eastabrooka/Deltafoc/BaselineRP2040MotorController/BaselineRP2040MotorController.kicad_pcb

## KiCad design BaselineRP2040MotorController/BaselineRP2040MotorController.kicad_pcb (2024-09-08)

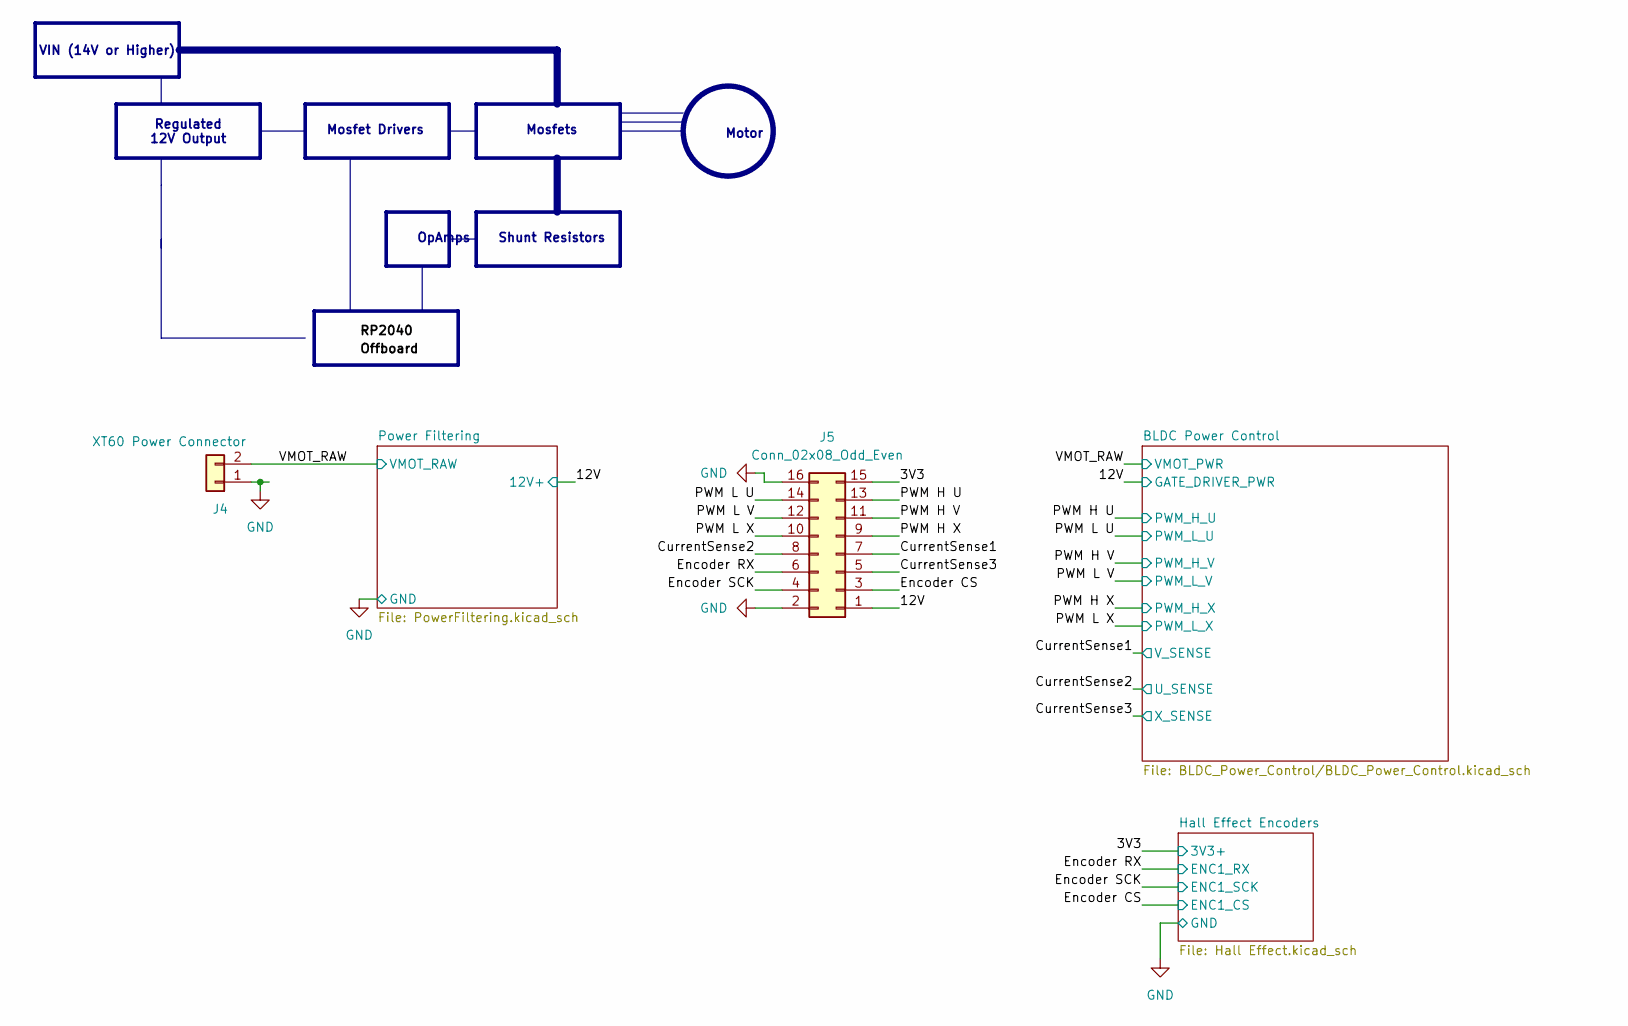
[picture p8: schematic BaselineRP2040MotorController.kicad_sch, BLDC Starting Point]

Parts:
J4: XT60 Power Connector; CONN-TH_XT60UPB-M; LCSC C428722
J5: Conn_02x08_Odd_Even; PinHeader_2x08_P2.54mm_Horizontal

Connections:
+3V3: J5.15; also elsewhere on the board
+12V: J5.1; also elsewhere on the board
/CurrentSense1: J5.7; also elsewhere on the board
/CurrentSense2: J5.8; also elsewhere on the board
/CurrentSense3: J5.5; also elsewhere on the board
/Encoder CS: J5.3; also elsewhere on the board
/Encoder RX: J5.6; also elsewhere on the board
/Encoder SCK: J5.4; also elsewhere on the board
/PWM H U: J5.13; also elsewhere on the board
/PWM H V: J5.11; also elsewhere on the board
/PWM H X: J5.9; also elsewhere on the board
/PWM L U: J5.14; also elsewhere on the board
/PWM L V: J5.12; also elsewhere on the board
/PWM L X: J5.10; also elsewhere on the board
GND: J4.1, J5.2, J5.16; also elsewhere on the board
VMOT_PWR: J4.2; also elsewhere on the board

Notes on the sheet:
Motor
Mosfets
VIN (14V or Higher)
OpAmps
Regulated 12V Output
Shunt Resistors
Mosfet Drivers

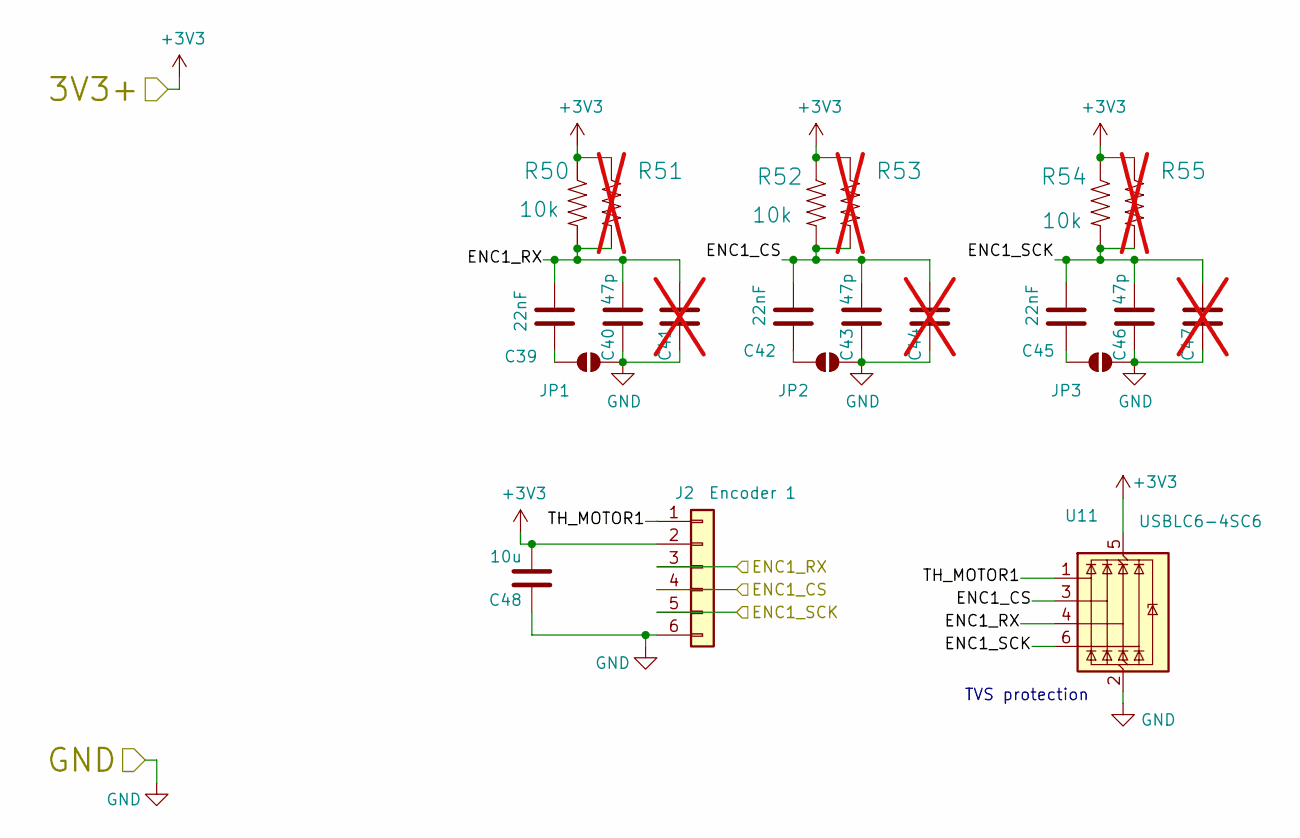
[picture p9: schematic Hall Effect.kicad_sch, BLDC Starting Point]

Parts:
C39, C42, C45: 22nF; C_0805_2012Metric; LCSC C77069
C40, C43, C46: 47p; C_0603_1608Metric; LCSC C1671
C41, C44, C47: C_0805_2012Metric; not fitted
C48: 10u; C_0805_2012Metric; LCSC C15850
J2: Encoder 1; RJ14_Connfly_DS1133-S6_Horizontal; LCSC C2982035
JP1, JP2, JP3: SolderJumper_2_Open; SolderJumper-2_P1.3mm_Open_RoundedPad1.0x1.5mm
R50, R52, R54: 10k; R_0603_1608Metric; LCSC C25804
R51, R53, R55: R_0805_2012Metric; not fitted
U11: USBLC6-4SC6; SOT-23-6; LCSC C558419

Connections:
+3V3: C48.2, J2.2, R50.1, R51.1, R52.1, R53.1, R54.1, R55.1, U11.5 (VBUS); also elsewhere on the board
/Encoder CS: C42.1, C43.2, C44.2, J2.4, R52.2, R53.2, U11.3 (I/O2); also elsewhere on the board
/Encoder RX: C39.2, C40.2, C41.2, J2.3, R50.2, R51.2, U11.4 (I/O3); also elsewhere on the board
/Encoder SCK: C45.1, C46.2, C47.2, J2.5, R54.2, R55.2, U11.6 (I/O4); also elsewhere on the board
/Hall Effect Encoders/TH_MOTOR1: J2.1, U11.1 (I/O1)
GND: C40.1, C41.1, C43.1, C44.1, C46.1, C47.1, C48.1, J2.6, JP1.1 (A), JP2.1 (A), JP3.1 (A), U11.2 (GND); also elsewhere on the board
unnamed: C39.1, JP1.2 (B)
unnamed: C42.2, JP2.2 (B)
unnamed: C45.2, JP3.2 (B)

Notes on the sheet:
TVS protection

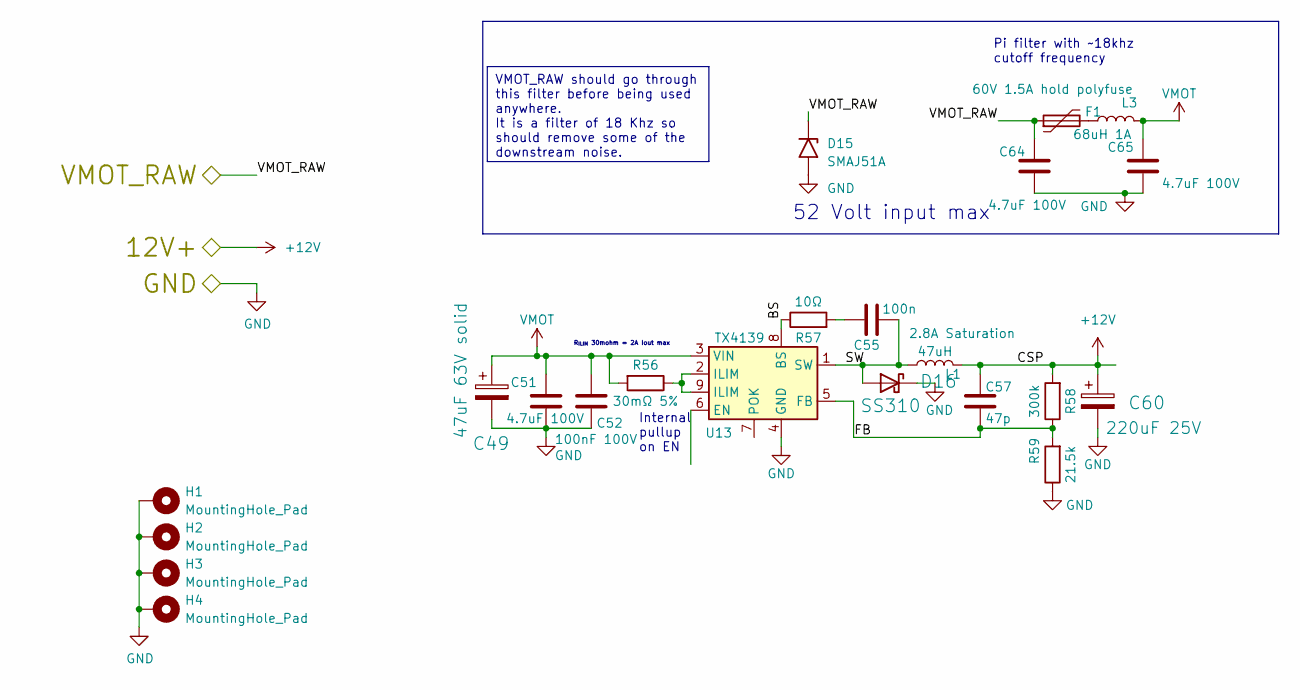
[picture p10: schematic PowerFiltering.kicad_sch, BLDC Starting Point]

Parts:
C49: 47uF 63V solid; CP_Elec_8x10.5; LCSC C5246568
C51, C64, C65: 4.7uF 100V; C_1210_3225Metric; LCSC C342614
C52: 100nF 100V; C_0805_2012Metric; LCSC C28233
C55: 100n; C_0603_1608Metric; LCSC C14663
C57: 47p; C_0603_1608Metric; LCSC C1671
C60: 220uF 25V; CP_Elec_6.3x7.7; LCSC C340768
D15: SMAJ51A; D_SMC; LCSC C438169
D16: SS310; D_SMA; LCSC C15874
F1: 60V 1.5A hold polyfuse; Fuse_2920_7451Metric; LCSC C6165178
H1, H2, H3, H4: MountingHole_Pad; MountingHole_3.2mm_M3_DIN965_Pad_TopBottom
L1: 47uH; L_Chilisin_BMRB00060612; LCSC C5189938
L3: 68uH 1A; L_Sunlord_SWPA6045S; LCSC C53663
R56: 30mΩ 5%; R_0603_1608Metric; LCSC C407492
R57: 10Ω; R_0603_1608Metric; LCSC C22859
R58: 300k; R_0603_1608Metric; LCSC C335091
R59: 21.5k; R_0603_1608Metric; LCSC C705916
U13: TX4139; SOIC-8-1EP_3.9x4.9mm_P1.27mm_EP2.29x3mm_ThermalVias; LCSC C329266

Connections:
+12V: C57.1, C60.1, L1.2, R58.2; also elsewhere on the board
/Power Filtering/BS: R57.1, U13.8 (BS)
/Power Filtering/FB: C57.2, R58.1, R59.2, U13.5 (FB)
/Power Filtering/SW: C55.1, D16.2 (A), L1.1, U13.1 (SW)
GND: C49.2, C51.2, C52.2, C60.2, C64.2, C65.2, D15.2 (A2), D16.1 (K), H1.1, H2.1, H3.1, H4.1, R59.1, U13.4 (GND); also elsewhere on the board
unnamed: C55.2, R57.2
unnamed: F1.2, L3.1
unnamed: R56.1, U13.2 (ILIM), U13.9 (ILIM)
VMOT: C49.1, C51.1, C52.1, C65.1, L3.2, R56.2, U13.3 (VIN)
VMOT_PWR: C64.1, D15.1 (A1), F1.1; also elsewhere on the board

Notes on the sheet:
VMOT_RAW should go through this filter before being used anywhere. It is a filter of 18 Khz so should remove some of the downstream noise.
Internal pullup on EN
52 Volt input max
R_{ILIM} 30mohm = 2A Iout max
Pi filter with ~18khz cutoff frequency

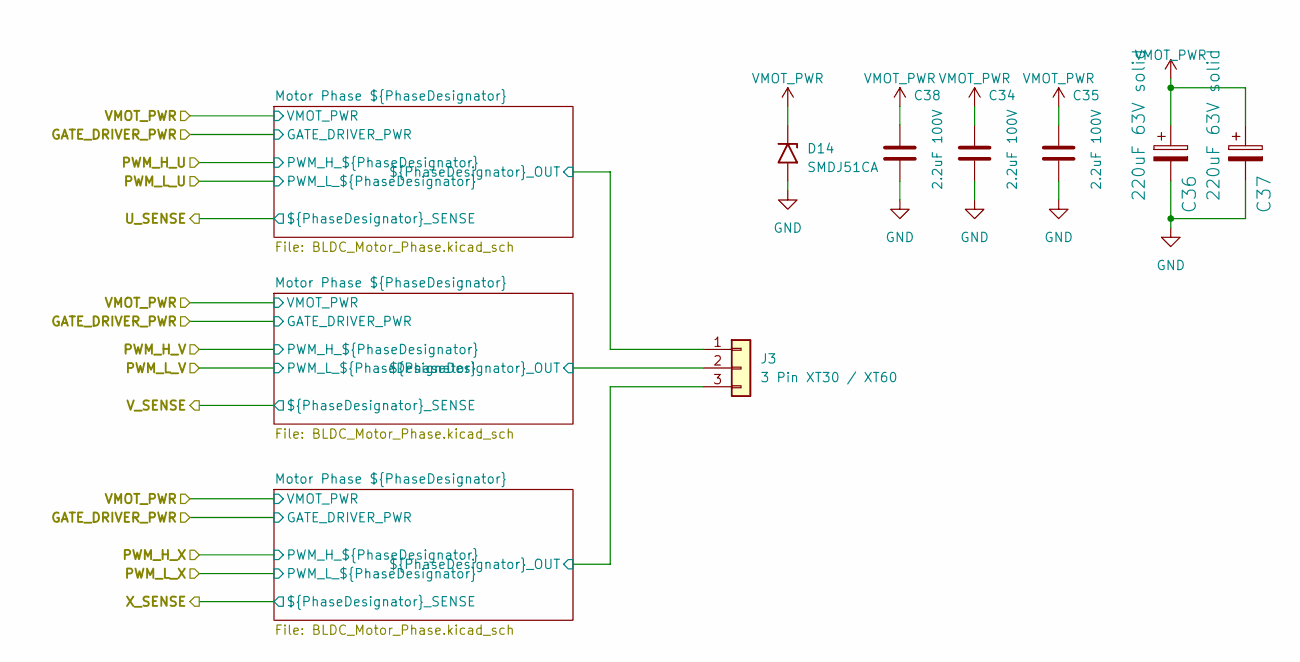
[picture p11: schematic BLDC_Power_Control.kicad_sch, BLDC Starting Point]

Parts:
C34, C35, C38: 2.2uF 100V; C_1206_3216Metric; LCSC C650969
C36, C37: 220uF 63V solid; CP_Elec_8x10; MPN 2210631013R00; LCSC C5455531
D14: SMDJ51CA; D_SMF; LCSC C406702
J3: 3 Pin XT30 / XT60; MT60-F.G.Y; LCSC C99176

Connections:
/BLDC Power Control/Motor Phase U/A_N: J3.1; also elsewhere on the board
/BLDC Power Control/Motor Phase V/A_N: J3.2; also elsewhere on the board
/BLDC Power Control/Motor Phase X/A_N: J3.3; also elsewhere on the board
GND: C34.2, C35.2, C36.2, C37.2, C38.2, D14.2 (A2); also elsewhere on the board
VMOT_PWR: C34.1, C35.1, C36.1, C37.1, C38.1, D14.1 (A1); also elsewhere on the board

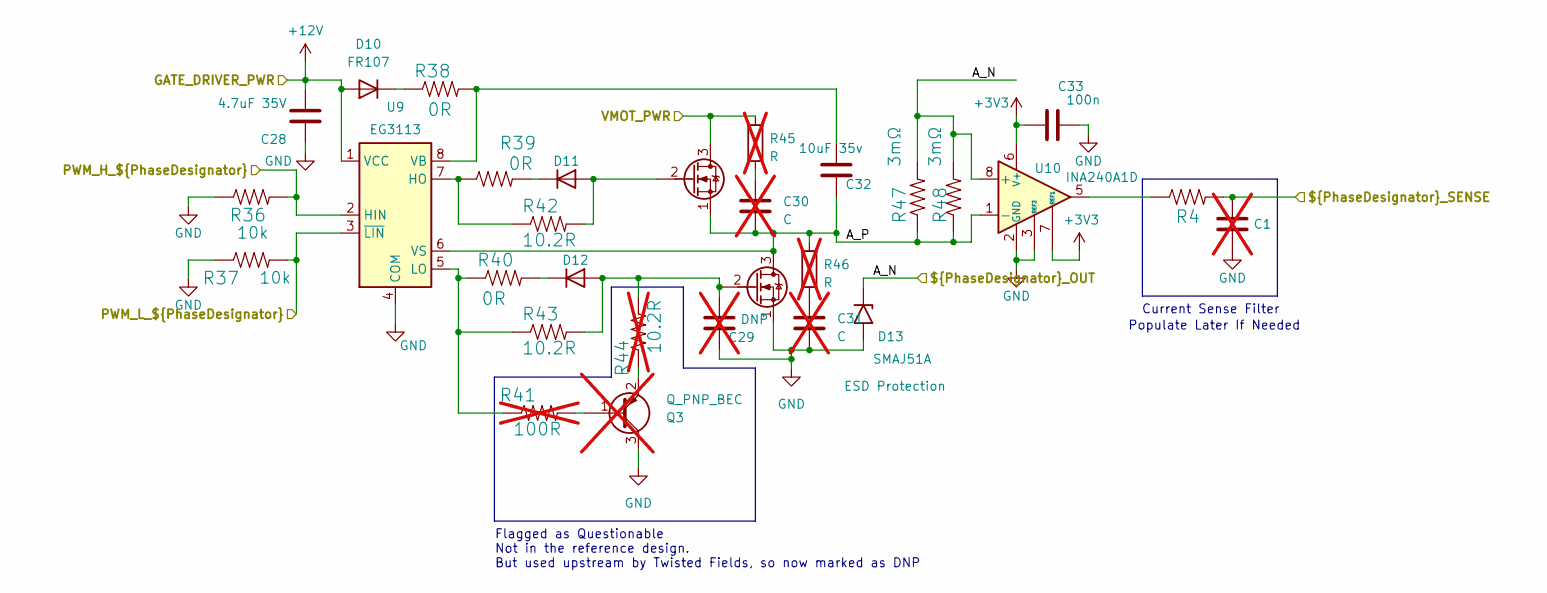
[picture p12: schematic BLDC_Motor_Phase.kicad_sch, BLDC Starting Point]

Parts:
AH3: MOSFETSO-8; PowerPAK_SO-8_123; LCSC C501507
AL3: MOSFETSO-8; PowerPAK_SO-8_123; LCSC C501507
C1: 0; C_0603_1608Metric; LCSC C14663; not fitted
C28: 4.7uF 35V; C_0603_1608Metric; LCSC C162274
C29: DNP; C_0603_1608Metric; not fitted
C30, C31: C; C_0805_2012Metric; not fitted
C32: 10uF 35v; C_0603_1608Metric; LCSC C194427
C33: 100n; C_0603_1608Metric; LCSC C14663
D10: FR107; D_SOD-123; LCSC C511885
D11, D12: CDBU0130R-HF; D_SOD-523; LCSC C2886025
D13: SMAJ51A; D_SMF; LCSC C726760
Q3: Q_PNP_BEC; SOT-23; LCSC C686646; not fitted
R4: 0; R_0603_1608Metric; LCSC C2933129
R36, R37: 10k; R_0603_1608Metric; LCSC C25804
R38, R39, R40: 0R; R_0603_1608Metric; LCSC C21189
R41: 100R; R_0603_1608Metric; LCSC C22775; not fitted
R42, R43: 10.2R; R_0603_1608Metric; LCSC C2933129
R44: 10.2R; R_0603_1608Metric; LCSC C2933129; not fitted
R45, R46: R; R_0805_2012Metric; not fitted
R47, R48: 3mΩ; R_2512_6332Metric; LCSC C2688862
U9: EG3113; SOIC-8_3.9x4.9mm_P1.27mm; LCSC C480666
U10: INA240A1D; SOIC-8_3.9x4.9mm_P1.27mm; LCSC C1346458

Connections:
+3V3: C33.1, U10.6 (V+), U10.7 (REF1); also elsewhere on the board
+12V: C28.2, D10.2 (A), U9.1 (VCC); also elsewhere on the board
/BLDC Power Control/Motor Phase X/A_N: D13.1 (A1), R47.2, R48.2, U10.8 (+); also elsewhere on the board
/BLDC Power Control/Motor Phase X/A_P: AH3.1 (S), AL3.3 (D), C30.2, C32.1, R46.1, R47.1, R48.1, U9.6 (VS), U10.1 (-)
/CurrentSense2: C1.2, R4.2; also elsewhere on the board
/PWM H X: R36.2, U9.2 (HIN); also elsewhere on the board
/PWM L X: R37.2, U9.3 (~LIN); also elsewhere on the board
GND: AL3.1 (S), C1.1, C28.1, C29.1, C31.2, C33.2, D13.2 (A2), Q3.3 (C), R36.1, R37.1, U9.4 (COM), U10.2 (GND), U10.3 (REF2), U10.4 (GND); also elsewhere on the board
unnamed: AH3.2 (G), D11.2 (A), R42.2
unnamed: AL3.2 (G), C29.2, D12.2 (A), R43.2, R44.2
unnamed: C30.1, R45.2
unnamed: C31.1, R46.2
unnamed: D10.1 (K), R38.1
unnamed: D11.1 (K), R39.2
unnamed: D12.1 (K), R40.2
unnamed: Q3.1 (B), R41.2
unnamed: Q3.2 (E), R44.1
unnamed: R39.1, R42.1, U9.7 (HO)
unnamed: R40.1, R41.1, R43.1, U9.5 (LO)
unnamed: C32.2, R38.2, U9.8 (VB)
VMOT_PWR: AH3.3 (D), R45.1; also elsewhere on the board

Parts of its further copies:
AH1, AH2: MOSFETSO-8; PowerPAK_SO-8_123; LCSC C501507
AL1, AL2: MOSFETSO-8; PowerPAK_SO-8_123; LCSC C501507
C2, C3: 0; C_0603_1608Metric; LCSC C14663; not fitted
C16, C22: 4.7uF 35V; C_0603_1608Metric; LCSC C162274
C17, C23: DNP; C_0603_1608Metric; not fitted
C18, C19, C24, C25: C; C_0805_2012Metric; not fitted
C20, C26: 10uF 35v; C_0603_1608Metric; LCSC C194427
C21, C27: 100n; C_0603_1608Metric; LCSC C14663
D2, D6: FR107; D_SOD-123; LCSC C511885
D3, D4, D7, D8: CDBU0130R-HF; D_SOD-523; LCSC C2886025
D5, D9: SMAJ51A; D_SMF; LCSC C726760
Q1, Q2: Q_PNP_BEC; SOT-23; LCSC C686646; not fitted
R5, R6: 0; R_0603_1608Metric; LCSC C2933129
R10, R11, R23, R24: 10k; R_0603_1608Metric; LCSC C25804
R12, R13, R14, R25, R26, R27: 0R; R_0603_1608Metric; LCSC C21189
R15, R28: 100R; R_0603_1608Metric; LCSC C22775; not fitted
R16, R17, R29, R30: 10.2R; R_0603_1608Metric; LCSC C2933129
R18, R31: 10.2R; R_0603_1608Metric; LCSC C2933129; not fitted
R19, R20, R32, R33: R; R_0805_2012Metric; not fitted
R21, R22, R34, R35: 3mΩ; R_2512_6332Metric; LCSC C2688862
U5, U7: EG3113; SOIC-8_3.9x4.9mm_P1.27mm; LCSC C480666
U6, U8: INA240A1D; SOIC-8_3.9x4.9mm_P1.27mm; LCSC C1346458

Connections of its further copies:
+3V3: C21.1, C27.1, U6.6 (V+), U6.7 (REF1), U8.6 (V+), U8.7 (REF1); also elsewhere on the board
+12V: C16.2, C22.2, D2.2 (A), D6.2 (A), U5.1 (VCC), U7.1 (VCC); also elsewhere on the board
/BLDC Power Control/Motor Phase U/A_N: D5.1 (A1), R21.2, R22.2, U6.8 (+); also elsewhere on the board
/BLDC Power Control/Motor Phase U/A_P: AH1.1 (S), AL1.3 (D), C18.2, C20.1, R20.1, R21.1, R22.1, U5.6 (VS), U6.1 (-)
/BLDC Power Control/Motor Phase V/A_N: D9.1 (A1), R34.2, R35.2, U8.8 (+); also elsewhere on the board
/BLDC Power Control/Motor Phase V/A_P: AH2.1 (S), AL2.3 (D), C24.2, C26.1, R33.1, R34.1, R35.1, U7.6 (VS), U8.1 (-)
/CurrentSense1: C2.2, R5.2; also elsewhere on the board
/CurrentSense3: C3.2, R6.2; also elsewhere on the board
/PWM H U: R10.2, U5.2 (HIN); also elsewhere on the board
/PWM H V: R23.2, U7.2 (HIN); also elsewhere on the board
/PWM L U: R11.2, U5.3 (~LIN); also elsewhere on the board
/PWM L V: R24.2, U7.3 (~LIN); also elsewhere on the board
GND: AL1.1 (S), AL2.1 (S), C2.1, C3.1, C16.1, C17.1, C19.2, C21.2, C22.1, C23.1, C25.2, C27.2, D5.2 (A2), D9.2 (A2), Q1.3 (C), Q2.3 (C), R10.1, R11.1, R23.1, R24.1, U5.4 (COM), U6.2 (GND), U6.3 (REF2), U6.4 (GND), U7.4 (COM), U8.2 (GND), U8.3 (REF2), U8.4 (GND); also elsewhere on the board
unnamed: AH1.2 (G), D3.2 (A), R16.2
unnamed: AH2.2 (G), D7.2 (A), R29.2
unnamed: AL1.2 (G), C17.2, D4.2 (A), R17.2, R18.2
unnamed: AL2.2 (G), C23.2, D8.2 (A), R30.2, R31.2
unnamed: C18.1, R19.2
unnamed: C19.1, R20.2
unnamed: C24.1, R32.2
unnamed: C25.1, R33.2
unnamed: D2.1 (K), R12.1
unnamed: D3.1 (K), R13.2
unnamed: D4.1 (K), R14.2
unnamed: D6.1 (K), R25.1
unnamed: D7.1 (K), R26.2
unnamed: D8.1 (K), R27.2
unnamed: Q1.1 (B), R15.2
unnamed: Q1.2 (E), R18.1
unnamed: Q2.1 (B), R28.2
unnamed: Q2.2 (E), R31.1
unnamed: R5.1, U8.5
unnamed: R13.1, R16.1, U5.7 (HO)
unnamed: R14.1, R15.1, R17.1, U5.5 (LO)
unnamed: C20.2, R12.2, U5.8 (VB)
unnamed: R26.1, R29.1, U7.7 (HO)
unnamed: R27.1, R28.1, R30.1, U7.5 (LO)
unnamed: C26.2, R25.2, U7.8 (VB)
VMOT_PWR: AH1.3 (D), AH2.3 (D), R19.1, R32.1; also elsewhere on the board

Notes on the sheet:
Populate Later If Needed
Flagged as Questionable Not in the reference design. But used upstream by Twisted Fields, so now marked as DNP
Current Sense Filter

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
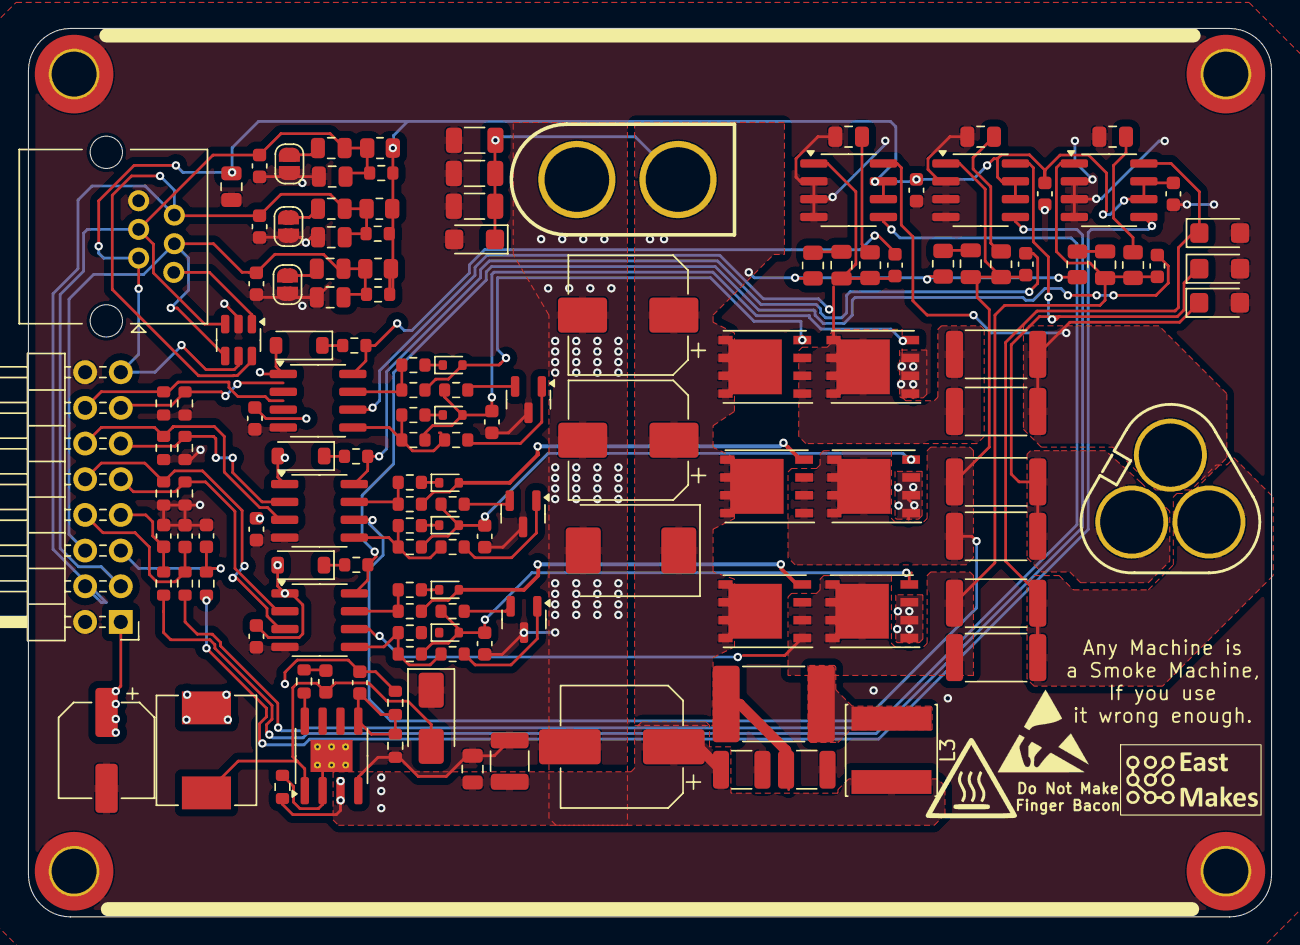
[picture p13: board BaselineRP2040MotorController.kicad_pcb from above]

Board: 2 copper layers, 88.5 x 63.2 mm, 142 parts (0 on the bottom side), 72 nets.
