eastabrooka/Deltafoc/(commit log)

2024-08-28 Back from Cruise - Upload and Squash.
    [BLDC_Motor_Phase.kicad_sch, BLDC_Power_Control.kicad_sch, BaselineRP2040MotorController.kicad_pcb, BaselineRP2040MotorController.kicad_sch, DC_Voltage_Sensor.kicad_sch, Hall Effect.kicad_sch, PowerFiltering.kicad_sch, RS485.kicad_sch]
2024-08-28 Change Mosfet Footprint.
    [BLDC_Motor_Phase.kicad_sch, BLDC_Power_Control.kicad_sch, BaselineRP2040MotorController.kicad_pcb, BaselineRP2040MotorController.kicad_sch, DC_Voltage_Sensor.kicad_sch, Hall Effect.kicad_sch, PowerFiltering.kicad_sch, RS485.kicad_sch]
2024-08-28 Continue Work
    [BaselineRP2040MotorController.kicad_pcb]
2024-08-28 Drop some features.
    [BLDC_Power_Control.kicad_sch, BaselineRP2040MotorController.kicad_pcb, BaselineRP2040MotorController.kicad_sch, DC_Voltage_Sensor.kicad_sch, Hall Effect.kicad_sch, RaspberryPiPico.kicad_sch]
2024-08-28 Just before dropping the self build of the 2040
    [BLDC_Power_Control.kicad_sch, BaselineRP2040MotorController.kicad_sch, RaspberryPiPico.kicad_sch]
2024-08-28 Going to take a break.
    [BaselineRP2040MotorController.kicad_pcb, BaselineRP2040MotorController.kicad_sch]
2024-09-06 Release for Review
    [BLDC_Power_Control.kicad_sch, BaselineRP2040MotorController.kicad_sch, Hall Effect.kicad_sch, PowerFiltering.kicad_sch]
2024-09-07 Generate PDF
    [BLDC_Motor_Phase.kicad_sch, BLDC_Power_Control.kicad_sch, BaselineRP2040MotorController.kicad_sch, Hall Effect.kicad_sch, PowerFiltering.kicad_sch]
2024-09-07 Post Feedback Changes.
    [BLDC_Motor_Phase.kicad_sch, BLDC_Power_Control.kicad_sch, BaselineRP2040MotorController.kicad_sch, PowerFiltering.kicad_sch]
2024-09-07 Should have been a 4 layer board.
    [BLDC_Motor_Phase.kicad_sch, BaselineRP2040MotorController.kicad_pcb, BaselineRP2040MotorController.kicad_sch, PowerFiltering.kicad_sch]
2024-09-07 Mounting points
    [BaselineRP2040MotorController.kicad_pcb, PowerFiltering.kicad_sch]
2024-09-11 Make Bom
    [BaselineRP2040MotorController.csv]
